danwerner21/SBC80386EX/SBC386/bios/0USAGE.TXT

/* 0usage.txt -- BIOS data Area by type of usage

/* derived from bda.h -- definitions at 0040:0000 (0x400)  */

/* Usage: serial			*/
	word	serial_dev[4];	/* serial port device codes */
	byte	serial_timeout[4];	/* one byte for each interface */
	byte	serial_flags[4];	/* flags for each serial device */
/* NVRAM setup info:			*/
	byte	nvram_info[2];		/* starts with 2 bytes of SIO0 params */

/* Usage: parallel (printer)	*/
	word	parallel_dev[4];	/* printer port device codes */
	byte	printer_timeout[4];

/* Usage: keyboard			*/
	byte	kbd_flag;	/* shift status &c. */
	byte	kbd_flag1;	/*  more  */
	byte	alt_input;	/* PC: accumulates Alt+numpad digits.  Here:
				   counts consecutive Ctrl-^ for the console
				   reset sequence -- see 16h_kbd.asm */
	byte	kbd_break_flag;	/* bit 7 set if Break key is pressed */
	word	buffer_head;
	word	buffer_tail;
	word	buffer_start;	/* offset of keyboard buffer start */
	word	buffer_end;		/* offset of end of kbd buffer */
	word	kbd_buffer[16];	/* buffer empty when  head==tail */
	byte	kbd_flag3;	/* mode state & type flags */
	byte	kbd_flag2;	/* kbd LED flags */

/* Usage: video (all)		*/
	byte	vid_mode;	/* current display mode */
	word	vid_columns;	/* no. of columns on the screen */
	word	vid_buf_len;	/* length of video buffer in bytes */
	word	vid_start;	/* start address of screen regeneration (in vid buf) */
	word	vid_cursor[8];	/* cursor postition on up to 8 screens */
	word	vid_cursor_mode;
	byte	vid_active_page;
	word	vid_addr_chip;	/* I/O address for the video chip (6845,EGA,VGA) */
	byte	vid_crt_mode;	/* current setting of the 3x8 register ???? */
	byte	vid_palette;	/* current color setting / palette  */
/* EGA/PGA specific			*/
	byte	ega_rows;		/* rows on the active screen (less 1) */
	word	ega_points;		/* bytes per character	*/
	byte	ega_info;		/* mode options ???? */
	byte	ega_info_3;		/* switch settings */
	byte	ega_rsvd[2];	/* reserved for adapter mfgrs */
	dword	ptr_ega_save;		/* far pointer to EGA parameter control block */

/* Usage: floppy (diskette)		*/
	byte	seek_status;	/* drive recalibration status */
					/* bits 3..0 drive must recalibrate before next seek */
	byte	motor_status;	/* bits 3..0 motor running */
					/* bit 7 current op is write */
	byte	motor_count;	/* timeout counter for motor turn-off */
	byte	fd_status;	/* return code status byte */
	byte	fd_ctrl_stat[7];	/* controller return bytes */
	byte	fd_last_data_rate;	/* last data rate selected */
/* NVRAM setup info:			*/
	byte	floppy_tab[2];		/* floppy disk driver table */

/* Usage: hard (fixed) disk			*/
	byte	hd_status;	/* status info for hard disk */
#define disk_status1 hd_status
	byte	hd_number;	/* number of hard disks (for int 13h, fn 8h) */
	byte	control_byte;	/* head control ???? */
	byte	port_offset;	/* obsolete, maybe ???? */
	byte	hd_status_reg;		/* hard disk status register */
	byte	hd_error_reg;		/* hard disk error register */
	byte	hd_int_flag;	/* HD interrupt flag */
	byte	hd_cntrl;		/* HD/FD combo controller bit flag */
	byte	hd_media[2];	/* media state */
	byte	hd_op_start[2];	/* operation start state */
	word	hd_track;		/* HD present cylinder number */
/* NVRAM setup info:			*/
	byte	disk_tab[8];  		/* hard disk driver table */

/* Usage: timer & rtc		*/
	word	timer_count_low;	/* low word of timer count */
	word	timer_count_high;
#define timer_count timer_count_low
	byte	timer_overflow;	/* timer has rolled over since last read */
/* motor_count, serial_timeout[4] & printer_timeout[4] -- see above */
	dword	rtc_user_flag_addr;	/* far address of user's wait flag */
	dword	rtc_user_wait_flag;	/* user wait flag */
	byte	rtc_wait_active;	/* 01=busy, 80=posted, 00=post acknowledge */

/* Usage: POST				*/
	byte	mfg_test;		/* initialization flags */
	byte	mfg_err_flag;
	byte	mfg_err_flag2;
	word	reset_flag;	/* word=0x1234 if Reset is underway (80286) */
	byte	AT_status_byte;	/* at 40:100h, 00500h, Print Screen Status byte */
/* SBC386 specific:			*/
	word	extended_memory;	/* size of Extended Memory in Kilobytes */
			/* this size is stored in CMOS on the PC/AT */
	word	CPU_freq;	/* CPU frequency in kilohertz */
	word	ebda_seg_ptr;		/* for EBDA allocations; c.f., memory_size */
					/* 00=ready/ok  01=busy  0FF=error	*/
	byte	SRAM_size;	/* size of SRAM in Kilobytes */

/* Usage: miscellaneous		*/
	word	equip_flag;		/* int 12h equipment flags */
	word	memory_size;	/* base memory size in Kilowords (1024) */
	dword	io_rom_addr;	/* far word to ROM initialization routine */
	byte	interrupt_flag;	/* indicates an interrupt occurred */
	byte	rsvd_network[7];	/* reserved for network adapters */

	word	errno;				/* library error flag (errno.h) */
	byte	rsvd_unused[41];	/* reserved for 386EX usage */

/* Usage: NVRAM data area -- specific entries duplicated above		*/
	byte	nvram_info[2];	/* 31 bytes of NVRAM information (this may move) */
							/* starts with 2 bytes of SIO0 params */
	byte	floppy_tab[2];		/* floppy disk driver table */
	byte	disk_tab[8];  		/* hard disk driver table */
	byte	nvram_unused[17];
	word	nvram_checksum;	/* 31st byte of the NVRAM info */

/* end */
