danwerner21/SBC80386EX/TestROMS/386-0-05/SBC386-0-update-2017-11-29_0949.jpg

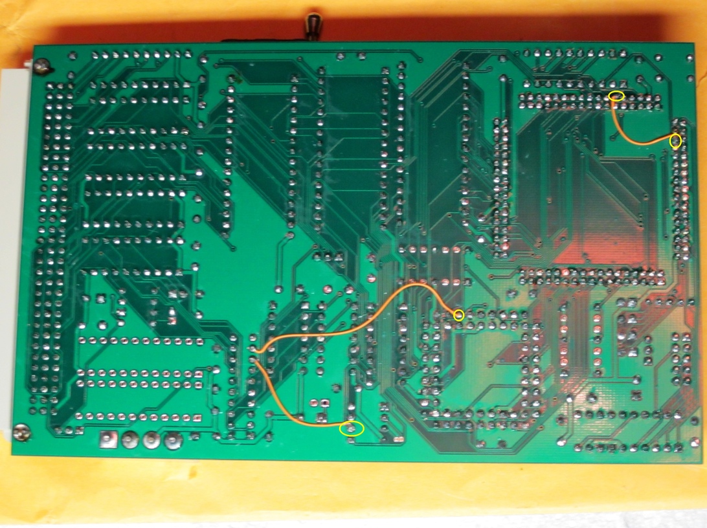
TestROMS/386-0-05/SBC386-0-update-2017-11-29_0949.jpg
