danwerner21/SBC80386EX/(list of files, drawings)

Other design files:
Hardware/SBC-386EX-2.0-kicad/SBC-386EX-2.dsn
