danwerner21/SBC80386EX/Hardware/SBC-386EX-2.0-kicad/SBC-386EX-2.kicad_pcb

## KiCad design Hardware/SBC-386EX-2.0-kicad/SBC-386EX-2.kicad_pcb (2026-09-06)

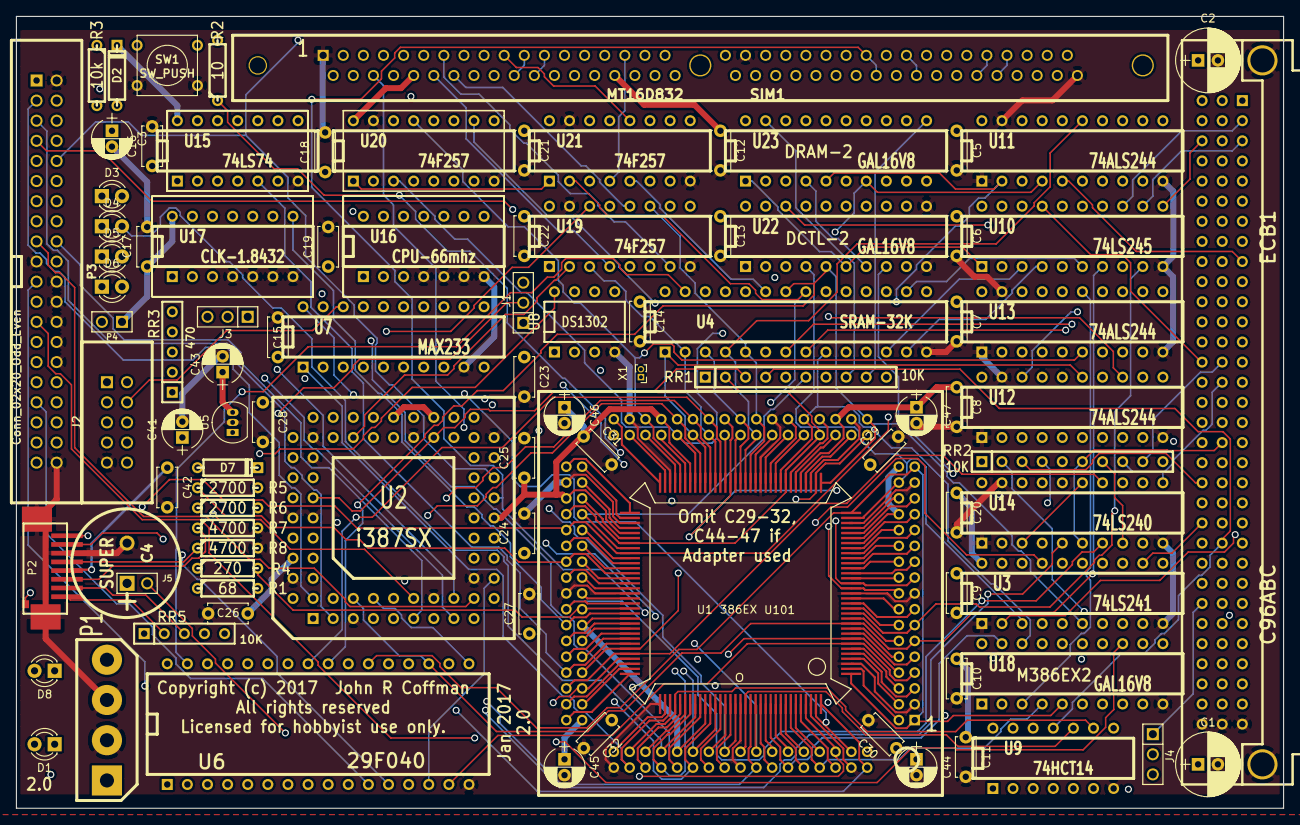
[picture p22: board SBC-386EX-2.kicad_pcb from above]

Board: 4 copper layers, 160.0 x 100.0 mm, 96 parts (0 on the bottom side), 215 nets.

Parts:
C1, C2: 22uF; CP_Radial_D8.0mm_P2.50mm
C3: 10uf; CP_Radial_D5.0mm_P2.00mm
C4: SUPER; SuperCap5
C5, C6, C7, C8, C9, C10, C11, C12, C13, C14, C15, C16, C17, C18, C19, C20, C21, C22, C23, C24, C25, C26, C27, C28, C29, C30, C31, C32: C; C_Disc_D5.0mm_W2.5mm_P5.00mm
C41: 4.7uF; CP_Radial_D5.0mm_P2.00mm
C42: 0.1; C_Disc_D5.0mm_W2.5mm_P5.00mm
C43, C44, C45, C46, C47: 10uF; CP_Radial_D5.0mm_P2.00mm
D1: R/G LED; LED_D3.0mm
D2: DIODE; D3
D3, D4, D5, D6: LED; LED_D3.0mm
D7: 1N4148; D3
D8: SD LED; LED_D3.0mm
ECB1: C96ABC; C96ABCM-RA
J1, J3, J4: Conn_01x03; PIN_ARRAY_3X1
J2: Conn_02x05_Odd_Even; SHROUDED_5x2
J5: Conn_01x02; PIN_ARRAY_2X1
P1: Conn_01x04; PCpower4
P2: microSD-01; microSD-Molex-47309
P3: Conn_02x20_Odd_Even; SHROUDED_20X2
P4: CONN_2; PIN_ARRAY_2X1
R1: 68; R3
R2: 10; R3
R3: 10k; R3
R4: 270; R3
R5, R6: 2700; R3
R7, R8: 4700; R3
RR1, RR2: 10K; r_pack9
RR3: 470; r_pack4
RR5: 10K; r_pack4
SIM1: MT16D832; DRAM-72-2021
SW1: SW_PUSH; SW_PUSH_SMALL
U1: I386EX_passive; i386EX-132-adapter
U2: i387SX; 80188
U3: 74LS241; DIP-20__300
U4: SRAM-32K; DIP-28__300
U5: LP2950-3.3_TO92; TO-92_Inline_Narrow_Oval
U6: 29F040; DIP-32__600
U7: MAX233; DIP-20__300
U8: DS1302; DIP-8__300
U9: 74HCT14; DIP-14__300
U10: 74LS245; DIP-20__300
U11, U12, U13: 74ALS244; DIP-20__300
U14: 74LS240; DIP-20__300
U15: 74LS74; DIP-14__300
U16: CPU-66mhz; DIP-14__300
U17: CLK-1.8432; DIP-14__300
U18, U22, U23: GAL16V8; DIP-20__300
U19, U20, U21: 74F257; DIP-16__300
U101: I386EX_PQFP; PQFP-132_i386_JRC
X1: CRYSTAL; Tuning_Fork_Header_Straight_1x02_Pitch1.00mm

Connections:
/DRAM/CAS: U22.12, U23.3
/DRAM/DR_A0: SIM1.12, U19.4
/DRAM/DR_A1: SIM1.13, U19.7
/DRAM/DR_A2: SIM1.14, U19.12
/DRAM/DR_A3: SIM1.15, U19.9
/DRAM/DR_A4: SIM1.16, U20.4
/DRAM/DR_A5: SIM1.17, U20.7
/DRAM/DR_A6: SIM1.18, U20.12
/DRAM/DR_A7: SIM1.28, U20.9
/DRAM/DR_A8: SIM1.31, U21.4
/DRAM/DR_A9: SIM1.32, U21.7
/DRAM/DR_A10: SIM1.19, U21.12
/DRAM/DR_A11: SIM1.29, U21.9
/DRAM/MUX: U19.1, U20.1, U21.1, U22.13
/DRAM/RAS: U22.14, U23.2
/DRAM/~CAS20: SIM1.40, SIM1.41, U23.13
/DRAM/~CAS31: SIM1.42, SIM1.43, U23.18
/DRAM/~RAS0: SIM1.44, U23.15
/DRAM/~RAS1: SIM1.45, U23.14
/DRAM/~RAS2: SIM1.34, U23.16
/DRAM/~RAS3: SIM1.33, U23.17
/DRAM/~WE: SIM1.47, U23.12
/SDcard/SD-CLK: P2.5, R6.2, R8.1
/SDcard/SD-DI: P2.3, R5.2, R7.1
/SDcard/VDD: C41.1, C42.1, D7.1, D8.1, P2.4, RR5.1, U5.1
/UART-SIO/R_RXD: J2.3, U7.4
/UART-SIO/R_TXD: J2.5, U7.5
/UART-SIO/~R_CTS: J2.6, J3.1
/UART-SIO/~R_DSR: J2.2, J3.3
/UART-SIO/~R_DTR: J2.4, J2.7, U7.18
/bus-IDE/IDE-PIN20: P3.20, P4.2
A1: P3.33, U1.42, U4.9, U6.11, U11.4, U18.18, U23.7, U101.42
A2: P3.36, U1.43, U2.48, U4.8, U6.10, U11.6, U18.7, U19.2, U101.43
A3: U1.44, U4.7, U6.9, U11.8, U18.8, U19.5, U101.44
A4: U1.45, U4.6, U6.8, U11.11, U19.14, U101.45
A5: U1.48, U4.5, U6.7, U11.13, U19.11, U101.48
A6: U1.49, U4.4, U6.6, U11.15, U20.2, U101.49
A7: U1.50, U4.3, U6.5, U11.17, U20.5, U101.50
A8: U1.51, U4.25, U6.27, U12.2, U20.14, U101.51
A9: U1.52, U4.24, U6.26, U12.4, U20.11, U101.52
A10: U1.53, U4.21, U6.23, U12.6, U21.2, U101.53
A11: U1.54, U4.23, U6.25, U12.8, U21.5, U101.54
A12: U1.55, U4.2, U6.4, U12.11, U19.3, U101.55
A13: U1.56, U4.26, U6.28, U12.13, U19.6, U101.56
A14: U1.57, U4.1, U6.29, U12.15, U19.13, U101.57
A15: U1.58, U6.3, U12.17, U19.10, U101.58
A16: U1.59, U6.2, U13.2, U20.3, U101.59
A17: J1.1, U1.61, U13.4, U20.6, U101.61
A18: U1.62, U6.1, U13.6, U20.13, U101.62
A19: U1.63, U13.8, U20.10, U101.63
A20: U1.65, U21.3, U101.65
A21: U1.66, U21.6, U101.66
A22: U1.67, U21.14, U23.8, U101.67
A23: U1.68, U2.45, U21.13, U101.68
A24: U1.70, U21.11, U23.9, U101.70
A25: U1.72, U21.10, U101.72
B_A0: ECB1.C5, U11.18
B_A1: ECB1.C7, U11.16
B_A2: ECB1.A6, U11.14
B_A3: ECB1.C6, U11.12
B_A4: ECB1.A7, U11.9
B_A5: ECB1.A8, U11.7
B_A6: ECB1.A9, U11.5
B_A7: ECB1.C9, U11.3
B_A8: ECB1.C8, U12.18
B_A9: ECB1.A30, U12.16
B_A10: ECB1.C18, U12.14
B_A11: ECB1.C17, U12.12
B_A12: ECB1.C27, U12.9
B_A13: ECB1.A29, U12.7
B_A14: ECB1.A18, U12.5
B_A15: ECB1.C28, U12.3
B_A16: ECB1.C10, U13.18
B_A17: ECB1.C12, U13.16
B_A18: ECB1.C13, U13.14
B_A19: ECB1.A14, U13.12
B_D0: ECB1.C2, U10.18
B_D1: ECB1.C14, U10.17
B_D2: ECB1.C4, U10.16
B_D3: ECB1.A4, U10.15
B_D4: ECB1.A5, U10.14
B_D5: ECB1.A2, U10.13
B_D6: ECB1.A3, U10.12
B_D7: ECB1.C3, U10.11
B_DT_~R: ECB1.B27, U13.7
B_HALT: D1.1, U14.5
B_VBAT: ECB1.A24, J5.2
B_~CLK: ECB1.C29, U13.3
B_~DREQ: ECB1.B23, RR1.4, U9.11
B_~HALT: ECB1.C25, R1.2, U14.3, U14.15
B_~INT: ECB1.B20, ECB1.C21, RR2.4, U14.2
B_~IORQ: ECB1.A27, U3.16
B_~IR2: ECB1.B19, RR2.5, U14.4
B_~IR3: ECB1.B18, RR2.6, U14.6
B_~IR5: ECB1.B16, RR2.7, U14.8
B_~IR6: ECB1.B15, RR2.8, U14.11
B_~IR7: ECB1.B14, RR2.9, U14.13
B_~M1: ECB1.A20, RR1.7, U13.9
B_~MREQ: ECB1.C30, U13.5
B_~NMI: ECB1.C20, RR2.3, U9.5
B_~RD: ECB1.C24, U3.14
B_~RESET: ECB1.C31, J4.2
B_~RESOUT: ECB1.C26, J4.1, U3.18
B_~WR: ECB1.C22, U3.12
CLK2: U1.115, U2.54, U16.8, U16.11, U22.1, U101.115
CLKOUT: U1.103, U9.9, U101.103
COMCLK: U1.87, U15.3, U17.8, U17.11, U101.87
CPU_PU: RR1.2, U1.41, U1.73, U1.99, U101.41, U101.73, U101.99
D0: P3.17, SIM1.2, SIM1.3, U1.5, U2.19, U4.11, U6.13, U10.2, U101.5
D1: P3.15, SIM1.4, SIM1.5, U1.6, U2.20, U4.12, U6.14, U10.3, U101.6
D2: P3.13, SIM1.6, SIM1.7, U1.7, U2.23, U4.13, U6.15, U10.4, U101.7
D3: P3.11, SIM1.8, SIM1.9, U1.8, U2.8, U4.15, U6.17, U10.5, U101.8
D4: P3.9, SIM1.20, SIM1.21, U1.10, U2.7, U4.16, U6.18, U10.6, U101.10
D5: P3.7, SIM1.22, SIM1.23, U1.11, U2.6, U4.17, U6.19, U10.7, U101.11
D6: P3.5, SIM1.24, SIM1.25, U1.12, U2.3, U4.18, U6.20, U10.8, U101.12
D7: P3.3, SIM1.26, SIM1.27, U1.13, U2.2, U4.19, U6.21, U10.9, U101.13
D8: P3.4, SIM1.49, SIM1.50, U1.14, U2.24, U101.14
D9: P3.6, SIM1.51, SIM1.52, U1.16, U2.28, U101.16
D10: P3.8, SIM1.53, SIM1.54, U1.18, U2.29, U101.18
D11: P3.10, SIM1.55, SIM1.56, U1.19, U2.30, U101.19
D12: P3.12, SIM1.57, SIM1.58, U1.20, U2.16, U101.20
D13: P3.14, SIM1.60, SIM1.61, U1.21, U2.15, U101.21
D14: P3.16, SIM1.62, SIM1.63, U1.22, U2.12, U101.22
D15: P3.18, SIM1.64, SIM1.65, U1.23, U2.11, U101.23
DREQ0: U1.117, U9.10, U101.117
DREQ1: P3.21, U1.118, U101.118
DSIZE: RR1.8, SIM1.67, U23.19
DT_~R: U1.30, U2.41, U10.1, U13.13, U22.6, U23.1, U101.30
D_~C: U1.29, U13.11, U22.8, U101.29
FPU_PU: RR1.3, U2.40, U2.59
GND: C1.2, C2.2, C3.2, C4.2, C5.2, C6.2, C7.2, C8.2, C9.2, C10.2, C11.2, C12.2, C13.2, C14.2, C15.2, C16.2, C17.2, C18.2, C19.2, C20.2, C21.2, C22.2, C23.2, C24.2, C25.2, C26.2, C27.2, C28.2, C29.2, C30.2, C31.2, C32.2, C41.2, C42.2, C43.2, C44.2, C45.2, C46.2, C47.2, ECB1.A32, ECB1.B32, ECB1.C32, ECB1.HOLE, J2.9, P1.2, P1.3, P2.6, P2.GND, P3.2, P3.19, P3.22, P3.24, P3.26, P3.28, P3.30, P3.40, R7.2, R8.2, SIM1.1, SIM1.39, SIM1.72, SW1.2, U1.3, U1.17, U1.31, U1.36, U1.46, U1.64, U1.69, U1.83, U1.97, U1.100, U1.116, U1.130, U1.134, U1.136, U2.5, U2.14, U2.21, U2.25, U2.27, U2.32, U2.34, U2.38, U2.42, U2.53, U2.55, U2.60, U2.61, U2.63, U2.66, U3.1, U3.10, U4.14, U5.2, U6.16, U7.6, U7.9, U8.4, U9.7, U10.10, U11.1, U11.10, U11.19, U12.1, U12.10, U12.19, U13.1, U13.10, U13.19, U14.1, U14.10, U14.19, U15.7, U16.4, U16.5, U16.6, U16.7, U17.4, U17.5, U17.6, U17.7, U18.10, U19.8, U19.15, U20.8, U20.15, U21.8, U21.15, U22.10, U22.11, U23.10, U101.3, U101.17, U101.31, U101.36, U101.46, U101.64, U101.69, U101.83, U101.97, U101.100, U101.116, U101.130
HALT: U14.17, U22.18
IDE-IR14: P3.31, U1.96, U101.96
IR1: U1.80, U14.18, U101.80
IR5: U1.82, U14.12, U101.82
IR6: U1.84, U14.9, U101.84
IR7: U1.85, U14.7, U101.85
IR9: U1.94, U14.16, U101.94
IR13: U1.95, U14.14, U101.95
M_~IO: U1.27, U2.44, U101.27
NMI: U1.90, U9.6, U101.90
unnamed: C4.1, J5.1, U8.8
unnamed: D1.2, R1.1
unnamed: D3.1, RR3.5
unnamed: D4.1, RR3.4
unnamed: D5.1, RR3.3
unnamed: D6.1, RR3.2
unnamed: D8.2, R4.1
unnamed: J1.2, U6.30
unnamed: J3.2, U7.19
unnamed: J4.3, R2.2, SW1.1
unnamed: P2.1, RR5.2
unnamed: P2.8, RR5.5
unnamed: U1.24, U101.24
unnamed: U1.25, U101.25
unnamed: U1.26, U101.26
unnamed: U1.76, U101.76
unnamed: U1.114, U101.114
unnamed: U1.120, U101.120
unnamed: U1.128, U101.128
unnamed: U7.10, U7.16
unnamed: U7.11, U7.15
unnamed: U7.12, U7.17
unnamed: U8.2, X1.1
unnamed: U8.3, X1.2
unnamed: U9.8, U13.17
unnamed: U15.2, U15.6
PEREQ: RR1.6, U1.74, U1.89, U2.56, U101.74, U101.89
RESET: U1.110, U2.51, U9.2, U9.3, U101.110
RTC_CLK: U1.104, U8.7, U101.104
RTC_DQ: RR1.5, U1.101, U8.6, U101.101
RTC_~RESET: U1.105, U8.5, U101.105
SD-CXS: R6.1, U1.77, U1.98, U101.77, U101.98
SD-RXS: P2.7, RR5.4, U1.78, U101.78
SD-TXS: R5.1, U1.79, U101.79
TMRCLK0: U1.93, U15.5, U101.93
T_RXD0: U1.129, U7.3, U101.129
T_TXD0: U1.131, U7.2, U101.131
VCC: C1.1, C2.1, C5.1, C6.1, C7.1, C8.1, C9.1, C10.1, C11.1, C12.1, C13.1, C14.1, C15.1, C16.1, C17.1, C18.1, C19.1, C20.1, C21.1, C22.1, C23.1, C24.1, C25.1, C26.1, C27.1, C28.1, C29.1, C30.1, C31.1, C32.1, C43.1, C44.1, C45.1, C46.1, C47.1, D2.2, D7.2, ECB1.A1, ECB1.B1, ECB1.C1, J1.3, P1.4, P4.1, R3.1, RR1.1, RR2.1, RR3.1, SIM1.10, SIM1.30, SIM1.59, U1.9, U1.15, U1.28, U1.38, U1.47, U1.60, U1.71, U1.81, U1.88, U1.109, U1.121, U1.127, U1.133, U1.135, U2.4, U2.9, U2.13, U2.22, U2.26, U2.31, U2.33, U2.37, U2.39, U2.43, U2.46, U2.50, U2.58, U2.62, U2.64, U3.20, U4.28, U5.3, U6.32, U7.7, U8.1, U9.14, U10.20, U11.20, U12.20, U13.20, U14.20, U15.1, U15.4, U15.14, U16.14, U17.14, U18.20, U19.16, U20.16, U21.16, U22.20, U23.20, U101.9, U101.15, U101.28, U101.38, U101.47, U101.60, U101.71, U101.81, U101.88, U101.109, U101.121, U101.127
~ADS: U1.40, U2.47, U22.2, U101.40
~BHE: U1.39, U23.6, U101.39
~BLE: P3.35, U1.37, U4.10, U6.12, U11.2, U23.5, U101.37
~BUSY: U1.92, U2.36, U101.92
~CS-IDE0: P3.37, U18.16
~CS-IDE1: P3.38, U18.17
~CS_DRAM: U1.124, U18.2, U101.124
~CS_LIO: U1.123, U18.1, U101.123
~CS_ROM: U1.1, U1.33, U6.22, U18.5, U101.1, U101.33
~CS_SRAM: U1.126, U4.20, U18.4, U101.126
~CS_XIO: U1.122, U3.4, U18.19, U101.122
~CS_XMEM: U1.125, U13.15, U18.3, U101.125
~DACK1: P3.29, U1.112, U18.6, U101.112
~DAT_EN: U10.19, U18.15
~DRAM: U18.14, U22.3
~EOP: ECB1.B26, RR2.2, U1.113, U101.113
~ERROR: U1.91, U2.35, U101.91
~IDE-RD: P3.25, U18.13
~IDE-WR: P3.23, U18.12
~LBA: U1.4, U3.19, U101.4
~LITE_0: D3.2, U1.106, U101.106
~LITE_1: D4.2, U1.107, U101.107
~LITE_2: D5.2, U1.108, U101.108
~LITE_3: D6.2, U1.111, U101.111
~RD: U1.34, U3.6, U4.22, U6.24, U18.11, U22.5, U101.34
~READY: U1.32, U2.49, U3.3, U22.4, U101.32
~READYO: U2.57, U3.17
~REFRESH: U1.2, U22.7, U23.4, U101.2
~RESET: P3.1, U3.2, U9.4
~RESET_0: C3.1, D2.1, R2.1, R3.2, U1.119, U9.1, U101.119
~SD-CD: P2.CD, RR1.10, U1.75, U101.75
~SD-CS: P2.2, R4.2, RR5.3, U1.86, U101.86
~SZ32: RR1.9, SIM1.68, U23.11
~T_CTS0: U1.132, U7.20, U101.132
~T_RTS0: U1.102, U7.1, U101.102
~WR: U1.35, U3.8, U4.27, U6.31, U18.9, U101.35
