danwerner21/SBC80386EX/(commit log)

2026-09-08 loading boot code from ide
    [11h_12h.obj, 14h_sio0.obj, 15h_misc.obj, 1Ah_time.obj, CPU386EX-2026-09-06-21-15-56.sch, CPU386EX-2026-09-06-21-16-44.sch, DRAM-2026-09-06-21-15-56.sch, DRAM-2026-09-06-21-16-44.sch]
2026-09-13 int 15 work
    [CPU386EX-2026-09-12-20-22-10.sch, CPU386EX-2026-09-12-20-22-55.sch, CPU386EX-2026-09-12-20-23-55.sch, DRAM-2026-09-12-20-22-10.sch, DRAM-2026-09-12-20-22-55.sch, DRAM-2026-09-12-20-23-55.sch, ECBbus-2026-09-12-20-22-10.sch, ECBbus-2026-09-12-20-22-55.sch]
2026-09-27 Coherent: gitignore allowlist, host tools, emulator scripts
    Begins item 13, the Coherent port. Everything under Coherent/ is now
    ignored unless re-included: the archives, partition images and install
    floppies are reference material and stay out of history.
    tools/cohfs.py read-only COHERENT filesystem reader (kit floppies)
    tools/qmp.py type keys / screenshot a headless QEMU over QMP
    tools/sercon.py run shell commands over the emulated COM1
    emu/run.sh QEMU with the CF card's exact 490/4/32 geometry
    .gitattributes keeps Coherent source byte-exact despite core.autocrlf.
2026-09-27 Coherent: import sys.r12 kernel source, untouched
    The COHERENT 4.2.12 kernel tree from Coherent/gtz/src.gtz (src/sys.r12,
    Mark Williams, July 1994), extracted byte for byte, including the
    prebuilt Driver.o/k386.a objects. Committed unmodified so every change
    made for the SBC-386EX reads as a diff against the original.
    This, not romana/relic/b/kernel (kernel 78) or relic/b/STREAMS (1993),
    is the source that matches the 4.2.10 install kit's /etc/conf.
2026-09-27 Coherent: push.sh, host-to-guest file transfer
    Packs files as a v7 tar on a FAT floppy that QEMU builds from
    Coherent/emu/xfer, then unpacks them over the serial console. Verified
    by rebuilding the at driver from sys.r12 inside Coherent: identical to
    the shipped Driver.o apart from the COFF timestamp and a __DATE__ string,
    which confirms sys.r12 as the source matching the 4.2.10 kit.
2026-09-27 Coherent: board device config; serial-console kernel boots in QEMU
    board/sdevice is the installed /etc/conf/sdevice with the drivers for PC
    hardware the SBC does not have at PC addresses turned off: fd, fdc (8237
    DMA floppy), mm (video), kb and console (8042 at 60h/64h). Built with
    idmkcoh from its own directory, and with condev patched to (5,128) --
    /dev/com1l -- it boots multi-user in QEMU with every message on COM1.
    Tools: sercon.py gains pull (byte-exact via uuencode) and watch, and logs
    to emu/serial.log. Not com1.log: COM1 is a reserved device name on
    Windows, which is also why QEMU's chardev logfile= never appeared.
    push.sh copes with Coherent's mkdir -p and with the guest clock be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
2026-09-27 Coherent: keep board/ config byte-exact like sys.r12
2026-09-27 Coherent: A20 via port 92h, patchable timer reload (pit_count)
    k0.s enabled A20 through the 8042 at 64h with LOOPNE from ECX=0. The SBC
    has no 8042 there: each read is a 209 ms bus-monitor timeout returning
    FFh, so the loop would spin 2^32 times -- a silent hang just after
    entering protected mode. Use the port 92h fast-A20 gate, which the
    386EX, PC chipsets and QEMU all have, leaving bit 0 (reset) clear.
    The timer 0 reload was the constant 11932, which assumes a 1.19318 MHz
    PIT. The SBC's timer 0 runs at COMCLK/2 = 921600 Hz and needs 9216. It
    is now pit_count, a patchable long in k0.s, read in real mode and used
    by busyWait()/busyWait2() in misc.c instead of T0_RATE. keeplist (new
    in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
2026-09-27 Coherent: board kernel -- BIOS memory sizing, 8-bit IDE, safe reset
    The first kernel meant for the SBC-386EX. Built in QEMU as /coh.sbc by
    board/mkboard.sh from the 4.2.12 library in sys.r12/conf with our
    objects; the QEMU copy /coh.sbcq (AT_8BIT=0, PC timer reload) boots to
    multi-user with every message on COM1.
    mchinit.c sized memory from CMOS 15h-18h. The SBC has no CMOS: FFFFh KB
    would be taken as 64 MB below 640K. k0.s now asks INT 12h and INT 15h
    AH=88h in real mode (the SBC BIOS answers both, touching only AX) and
    mchinit() uses those, falling back to CMOS only without an answer.
    at driver: AT_HFREG replaces the hard-wired 3F6 control register (the
    SBC's IDE chip select decodes o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
2026-09-27 Coherent: early_con -- progress and early printf straight to the UART
    First board run stopped silently after the kernel's "!". printf output
    is held until the drivers are up, and the start-up markers (CHIRP) went
    only to video memory, so nothing after "!" was visible on serial.
    early_con, a patchable long in k0.s (read through early_con_port(), like
    int11()), names a UART. When set, _chirp() also writes each marker to it
    polled (die.c: early_putc, bounded THRE wait, no statics), putchar()
    writes pre-driver output there instead of buffering it, and mchinit()
    prints the memory sizes it chose. mkboard.sh sets it to 0x3F8, and now
    relinks /autoboot, which pointed at the replaced kernel file.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
2026-09-27 Coherent: AT_DRIVE_CT=1 for the board; LOCK_TESTS says which check failed
    Board run 2 reached devinit(): memory [00068000 00F00000] as predicted,
    paging and early start-up fine, then
    rootdev = (13,0)
    PANIC : Lock primitives not functional
    rootdev: at_drive_ct defaults to 0, meaning "count the drive types in
    CMOS 12h". The SBC has no CMOS, the read came back with no types, and
    rpdev() put the root on SCSI (major 13). board/stune now says
    AT_DRIVE_CT 1, as the installer did for the stock /coherent.
    LOCK_TESTS(): pure logic over XCHG-based atomics and software priority
    levels, and it passes in QEMU, so something under it differs on the
    386EX. Each failing check now prints "L" and its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
2026-09-27 Coherent: clear memory at start, initialise sleep locks
    Board run 3: rootdev (11,0) now, and LOCK_TESTS named its failure --
    L00001103, line 4355, the first sleep-lock check. SLEEP_ALLOC() takes
    its memory from kmem_alloc(), which does not zero it, and never sets
    sl_locked or sl_holder, so a new sleep lock reads as whatever RAM held.
    QEMU starts with RAM zeroed and passes; the SBC's RAM holds the BIOS
    memory march's patterns after a cold start, so the lock looks taken.
    Two fixes:
    - ksynch.c: SLEEP_ALLOC() clears sl_locked and sl_holder, as LOCK_ALLOC()
    does for basic locks. Needed regardless of boot state: kmem_alloc()
    reuses freed memory on any machine.
    - mchinit.c: re-enable Hal's 9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
2026-09-27 Coherent: NDP_TYPE 1 on the board -- FPU emulation, skip detection
    Board run 4 got through the lock tests, both drivers and the banner,
    then faulted in ndpSense(), the coprocessor probe, at ffc1fd4d -- the
    second byte of fcompp, after fld1/fldz/fdivp/fld/fchs. The probe had
    found an FPU (fninit/fnstsw/fnstcw, as the BIOS's EquipFlag bit 1 does)
    and correctly ruled out a 486. Reported as a page fault, but eip is not
    on an instruction boundary and cr2=E6FA7DE7 looks like power-on noise:
    more likely an FPU error or interrupt arriving through the wrong vector
    than a real fault. Open, and a hardware question.
    Meanwhile board/stune sets NDP_TYPE 1, NDP_TYPE_NONE: detection is
    skipped and FP in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
2026-09-27 Coherent: AT_TRACE, a polled trace of the at driver on early_con
    Board: single-sector reads are quick, fsck finishes (slowly), but
    time dd if=/dev/rat0a of=/dev/null bs=16k count=20
    ran 6:11.8 without completing one 16 KB (32-sector) command. That fits
    each sector after the first waiting out the watchdog (d_time is reset
    to ATSECS*2 = 12 s per sector; 32 x 12 s = 6.4 min), which restarts the
    request a sector further on -- so at_tries never reaches SOFTLIM and
    nothing is printed.
    AT_TRACE (Space.c, default 0; switch on in the running kernel with
    /conf/patch -k) writes Rnn/Wnn per command, inn per interrupt with the
    status, "." per sector, Enn/Qnn/Bnn/Tnn for errors, DRQ and busy
    timeouts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
2026-09-27 Coherent: ATSREG 1FE on the board -- multi-sector reads now complete
    AT_TRACE on the board showed every multi-sector read losing all but its
    first interrupt: R07i58.T00R07i58.T00... -- one sector per 12 s
    watchdog -- while multi-sector writes got all of theirs (W03i58i58i50).
    After each sector the driver checks status through ATSREG, which was
    1F7, the main status register. Reading that acknowledges the drive's
    interrupt. A CF card has the next sector ready at once, so its
    interrupt was already up and was cleared before the interrupt controller
    latched it; writes are slow enough that the check came first. This is
    why the stock notes say ATSREG "needs to be 3F6 for most new IDE
    drives":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
2026-09-27 Coherent: board kernels boot quiet -- early_con 0 by default
    The start-up markers and early printf on COM1 were for bring-up; the
    board now boots clean to multi-user. Patch early_con=0x3F8 to get them
    back.
2026-09-28 Coherent: FPUTEST.COM, the kernel's FPU probe as a DOS program
    COHERENT's ndpSense() faulted on the SBC during the first real 387
    arithmetic, so the board runs with FP emulation (NDP_TYPE 1). The
    80387SX-25 has only ever been presence-checked by the BIOS. This runs
    the same sequence under DOS -- no COHERENT involved -- to separate a
    hardware problem from a kernel one: FNINIT/FNSTSW, FNSTCW, 2+3,
    355/113x10000, then the probe's exact bytes: 1/0 masked, -inf, FCOMPP.
    tools/mkcom.py builds a .COM from NASM-style source without NASM
    (keystone + capstone), working round keystone's 32-bit call/ret in
    16-bit mode and its reading of bare numbers as hex.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
2026-09-28 Coherent: NDP_TYPE 3 on the board -- use the 80387SX, skip the probe
    FPUTEST.COM under DOS on the SBC: every step correct, and the probe's
    own sequence (1/0 masked, -inf, FCOMPP) gives status 0124 -- the 387 and
    its wiring are fine. Then, with ndpType patched to 3 on the board so
    the kernel skips ndpSense() and gives user processes the real FPU,
    awk's floating point runs correctly (identical to QEMU).
    So only COHERENT's boot-time probe misbehaves on the 386EX. Why is not
    yet known; one candidate is setEmfR0 setting CR0 bit 5 (NE), which
    exists only on a 486 and is reserved on a 386. NDP_TYPE 3 declares
    the 387 instead. It must be fitted: without one this kernel would
    misbehave on the fi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
2026-09-28 Coherent: ECB VGA3 console and 8242 keyboard, alongside the serial port
    The PC console drivers (mm video, kb keyboard) back in the board kernel,
    driving the VGA3 as a second terminal, /dev/vga3 (2,0) with its own
    login. The serial port stays the system console: kernel messages and
    /dev/console are still COM1.
    Presence: k0.s keeps the SBC BIOS's bda.console (0040:0089) from real
    mode; CON_VIDEO is set when the VGA3 answered at POST. With CON_VGA 2
    the drivers use that: without the board the keyboard driver touches no
    port (a status wait on a missing controller would never end), and the
    screen writes land on the decoded, self-terminating CS3/CS0 windows.
    kb.c: ports are KB_DATA/KB_STAT (4E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
    [kb.c, mm.c]
2026-09-28 Coherent: find the VGA3 keyboard by probing the 8242, not bda.console
    Board with SETUP set to serial only: logins on both screen and serial,
    but the PS/2 keyboard dead. The BIOS runs vga3_init and kbc_init
    whatever SETUP says -- the 8242 was initialised -- then rewrites
    bda.console from the SETUP choice, clearing CON_VIDEO. So bda.console
    records a preference, and the keyboard driver had taken it for presence.
    CON_VGA 2 now probes as kbc_init does: an 8242 status port reading FFh
    has nothing behind it (in the CS0 ECB window an empty slot floats to FFh
    with no bus-monitor timeout). Looked at once and remembered. k0.s
    still keeps the bda.console byte, for reference only.
    QEMU twin with C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
2026-09-28 Coherent: README, and scripts that make the image from the source
    README.md: how to build a CF image for the SBC-386EX -- rebuilding after
    a source change, making the development disk from the 4.2.10 kit once
    (installer answers included), writing the card, the settings, the
    debugging aids, what was changed and why, and what is still open.
    The build no longer depends on commands typed during bring-up:
    emu/pushsrc.sh copies sys.r12/ and board/ into the VM
    board/mkkconf.sh makes /u/sbc/kconf from sys.r12/conf and rebuilds
    every object we changed into it
    emu/mkrelease.sh makes a tidy board image from the development disk
    emu/run.sh GUI=1 for a QEMU w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
2026-09-28 Coherent: the SBC-386EX install set -- five diskettes, board-ready install
    emu/mkdisks.sh makes sbc-d1.img .. sbc-d5.img: the 4.2.10 kit with disk 1
    asking for five diskettes (brc.install/brc.update: "/dev/fva0 5") and
    ending its post-install script with board/Coh_420.post.sbc, plus a new
    disk 5 -- the marker /Coh_420.5 and compressed/sbc.taz holding the board
    kernel, its twin, its symbols and board/ -- which /etc/install unpacks
    like the others. The hook runs board/setup.sh last, after everything
    that talks to the installer's console.
    Written on the host by tools/cohfsw.py, a COHERENT filesystem writer:
    mkfs reproduces COHERENT's own exactly (timestamps and some stray bytes
    past the super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
2026-10-02 Coherent: sbcfd.c, a polled floppy driver for the ECB FDC9266
    COHERENT's floppy support (fl386.c behind the "fdc" major-4 entry) drives
    an 8237 DMA channel and a controller at 3F0h; the SBC has neither. This
    replaces both: conf/fdc/src/sbcfd.c is the fdc device, fd (fl386) is off.
    The device interface is fl386's -- minor xxuuhkkk, formats by kind, so
    /dev/fva0 (1.44M), /dev/fqa0 (720K) and the rest mean what they did.
    The autosensing "special" devices are not supported.
    The hardware layer is the SBC BIOS's diskfdc.c/fdcpio.asm, which works
    under DOS: latch shadow (reset, motor, MINI, TC; write only), reset as a
    pulse then four SENSEs, SPECIFY with the non-DMA bit before every
    transfer, see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
    [sbcfd.c]
2026-10-03 Coherent: floppy data phase in assembly; fail fast on write protect
    The C data phase (busyWait for the first byte, then sphi and inb through
    function calls) missed the first byte of every sector at 500 kbps: ST1 10,
    overrun. fdpio.s ports the BIOS's fdcpio.asm -- the first byte waited for
    with interrupts on, the 512-byte burst with them off, MSR matched under E0.
    On the board: reads, mkfs, fsck, mount, cp and cmp on a 1.44M diskette.
    A write-protected diskette (ST1 NW) now fails at once with "write
    protected" instead of four tries and a reset per block, and a sector's
    result is cleared first so a stale one cannot be mistaken for it.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
    [sbcfd.c]
2026-10-03 Coherent: commit the images and the original kit; README for new users
    Everything needed to put COHERENT on an SBC-386EX is now in the
    repository:
    Coherent/images/ sbc-cf.img.gz, the CF card image (5 MB; 32 MB
    unpacked); sbc-b1.img and sbc-d2..d5.img, the board
    install set; sbc-d1.img, disk 1 for a QEMU install;
    SHA1SUMS
    Coherent/distrib/ the original COHERENT 4.2.10 kit, d1-d4, which
    mkdisks.sh and the development-disk install start from
    .gitignore re-includes both; .gitattributes marks them binary.
    mkdisks.sh now writes into images/. mkrelease.sh zeroes the free blocks
    of the finished image (cohfs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
2026-10-03 Coherent: install from diskettes only; the board work is GPL
    The ready-made CF image is gone from images/. It boots only a card the
    BIOS sees with the geometry it was partitioned for (490/4/32), which is
    seldom the case, and a card that comes out otherwise fails in ways that
    look like hardware faults. The diskette install partitions the card for
    whatever geometry the BIOS reports.
    README.md: the board install is now the way in, with both answer tables
    in one place, the expected boot and first steps. Installing in QEMU and
    mkrelease.sh stay, described as testing aids with the same geometry
    caveat. The licence section says the SBC-386EX work is GPL v3 or later,
    as the BIOS is; COHERENT it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
2026-10-03 Coherent: the board install works; README on checking diskettes
    Verified on the board: an install from sbc-b1.img and sbc-d2..d5.img
    with diskettes that read cleanly boots to multi-user. An earlier
    attempt left no /autoboot because disk 4 had unreadable sectors on its
    inner tracks (ST1 20 ST2 20, CRC errors in the data, from cylinder 57):
    lib.taz was lost, so neither the installer's kernel build nor setup.sh's
    cc could run, and the install carried on without saying so.
    tools/fdcheck.py reads a written diskette back on Windows and lists the
    blocks that differ or will not read. README: check every diskette
    first; watch for "fd0: block" lines while the archives unpack; take
    diskette 5 out at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
2026-10-04 Coherent: VGA3 console writes only in vertical blanking (CON_VBLANK)
    The VGA3's 32K is shared by the CPU and the HD6445 with no arbitration:
    a CPU access while the CRTC fetches corrupts the fetch, and the screen
    snowed. With CON_VBLANK set, mmas.s waits for vertical blanking (HD6445
    register 31 bit 1, through the data port) before every display access --
    mmputc's character, and blank and the scroll copies a row (80 cells) per
    wait -- as the SBC BIOS's vga3.asm does. Blanking is 1553 of 14271 usec,
    time for about thirteen rows.
    The wait is bounded at 65536 reads. Without a VGA3 the ECB slot floats
    to FFh at once, bit 1 reads set, and the wait costs nothing.
    CON_VBLANK is a console tunabl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
2026-10-04 Coherent: floppy formatting (FDFORMAT), and 8 tries a sector
    sbcfd.c takes fl386.c's FDFORMAT ioctl, so /etc/fdformat works: the
    argument is the track's C H R N table, and FORMAT TRACK (4Dh) is sent
    with the format's gap (6Ch 1.44M, 54h 1.2M, 50h the 250 kbps formats)
    and filler F6h, after a head-settle wait. Three tries a track, a reset
    before the last; write protect reported at once.
    The table goes in one burst with interrupts off for the revolution, as
    diskfdc.c does. A burst per four-byte group with interrupts on between
    was tried first and underran (ST1 10) about cylinder 30 on every
    diskette: a handler still running when the controller asked for the
    next group -- likely the IDE driv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
    [sbcfd.c]
2026-10-04 SBC386/sdcard: SDTEST, bring-up of the on-board microSD over the 386EX SSIO
    A DOS program (nasm -O9 -f bin -o SDTEST.COM sdtest.asm) that brings the
    socket up one rung at a time and says what it expected at each. On the
    board, with a 960 MB card: pins, CMD0, CMD8 (SD v2), ACMD41, CMD58
    (standard capacity), CID and CSD (CRC7 good), sector 0 and its partition
    table, 256 sector reads with CRC16 all good, 31 KB/s at 1.25 MHz.
    What it took, each step found on the hardware:
    - Transmitter master, receiver slave on the tied STXCLK/SRXCLK. The
    receiver as master saw stray bits.
    - The transmitter starts in step with the baud-rate generator, and its
    phase at that instant decides how the burst b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
2026-10-04 SBC386/sdcard: SDTEST 13 -- faster reads, writes, 89 KB/s
    On the board, 960 MB card: every step passes. Reads with CRC16 good at
    1, 1.25 and 1.67 MHz at every start delay; 256 sector reads at 89 KB/s
    (31 before); sector 2, in the gap before the partition, saved, written
    with a pattern, read back and compared, written back, read back and
    compared.
    - The data phase only reads: the transmitter is left to repeat FFFF,
    which is what the card wants, so the loop does half the work. The
    underflow that sets is expected and ignored; the overflow flag is not.
    - What comes after a command's window goes into a ring, unrolled after;
    nothing is skipped, so an early token cannot lose data (v11's "e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
    [sdtest.asm]
2026-10-04 SBC386/sdcard: SD.SYS, a DOS block driver for the on-board microSD
    DEVICE=SD.SYS gives one drive letter: the card's first FAT12/16
    partition (types 01, 04, 06, 0E), or a card with no partition table as
    one volume. 32-bit sector numbers, for partitions over 32 MB (DOS 4+).
    On the board, DOS 6.22, 960 MB card: DIR, TYPE, COPY both ways, FC, and
    CHKDSK all good.
    - sdcore.inc: SDTEST 13's routines, taken out of sdtest.asm by script so
    the code is the code that was proved, less its diagnostics, plus
    sd_start (the card from nothing, then the fastest clock that reads
    sector 0 right) and sd_read. The base for the COHERENT driver.
    - sd.asm: strategy and interrupt on a stack of its own; INIT,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
2026-10-04 create DOS SD driver
2026-10-04 Coherent: sbcsd.c, a driver for the on-board microSD socket
    /dev/mmc0a..mmc0d are the card's MBR partitions and /dev/mmc0x the whole
    card, block and raw, major 14 (mdevice; on in board/sdevice; nodes made
    by setup.sh). So a card written on a PC is "dos t /dev/mmc0a". On the
    board, 960 MB card: dos t, dos x, dos r, and the card then clean under
    DOS (CHKDSK, TYPE); 1 MB raw read in 23 s, 44 KB/s, at 1.25 MHz.
    It follows SBC386/sdcard/sdcore.inc, which SDTEST found and SD.SYS
    proved: transmitter master on the tied SSIO clocks, the baud-rate
    generator restarted at a set delay each burst, 20 FFs before a command,
    the receive offset found from R1, a read in one burst through a ring, a
    write in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
2026-10-04 Coherent: README and install diskettes for the SD card driver
    images/ rebuilt: the boot diskette's kernel and diskette 5's board
    kernel carry sbcsd.c, and diskette 5's setup.sh makes /dev/mmc0* --
    a fresh install has the SD card from the first boot.
    README: the SD card in "Using the system" (devices, dos commands, when
    the card is brought up, SD.SYS for DOS); MMC_DEBUG in the settings and
    the debugging aids; the driver in the change list; its limits -- 44 KB/s
    at 1.25 MHz, single-sector commands, partitioning on a PC, tested with
    one standard-capacity card.
2026-10-04 README.md for the repository: the board, its BIOS, COHERENT
    What the SBC-386EX is, from John Coffman's guide to the v2.0 schematic,
    with credit to him as its designer and a link to the RetroBrew wiki
    page; the BIOS, what it does, and how to build it (GNU make, NASM 2.08,
    Open Watcom 1.9, the helper tools in SBC386/tools); SD.SYS and SDTEST;
    COHERENT, pointing to Coherent/README.md for the install diskettes and
    directions; what is where; credits and licence. images/logo.png is the
    project's logo, at the top.
2026-10-04 sd drivers
