danwerner21/SBC80386EX/(notices)

Notices in the files:
Hardware/SBC-386EX-2.0-kicad/rescue-backup/Oscillators-2026-09-12-20-23-55.sch:
Copyright (C) 2017 John R Coffman. All rights reserved.
